hamishcoleman/thinkpad-usbkb/parts-required.ods

Sheet: Sheet1
Attempt to document required parts for a thinkpad keyboard adaptor
Keyboard Pinout:
pin 1 indicated with a silk-screen arrow on motherboard
pin 40 indicated with a circuit inscription on the keyboard
 | x230 signal | x220 signal | Pin | Pin | x220 signal | x230 signal
 | -HOTKEY | -HOTKEY | 1 | 2 | DRV4 | DRV4 | multimeter tests
 | SENSE5 | SENSE5 | 3 | 4 | DRV5 | DRV5 | red to gnd or 1
 | SENSE0 | SENSE0 | 5 | 6 | DRV8 | DRV8 | black to ledmicmute_r
 | SENSE3 | SENSE3 | 7 | 8 | DRV6 | DRV6 | led lights
 | SENSE2 | SENSE2 | 9 | 10 | DRV3 | DRV3
 | SENSE4 | SENSE4 | 11 | 12 | DRV7 | DRV7 | red to 1, black to 36, light
 | SENSE1 | SENSE1 | 13 | 14 | DRV2 | DRV2
 | SENSE6 | SENSE6 | 15 | 16 | DRV10 | DRV10 | red to 34, black to 1, continuity when Fn key pressed
 | SENSE7 | SENSE7 | 17 | 18 | DRV1 | DRV1
 | -PWRSWITCH | -PWRSWITCH | 19 | 20 | DRV9 | DRV9 | red to 34, black to 19, continuty – dropping off – when power key presses
 | ?? KBD_CN#21 | LEDCPSLOCK_CONN | 21 | 22 | DRV0 | DRV0
 | -LEDPWR | LEDPWR_CONN | 23 | 24 | DRV11 | DRV11 | red to 31ish, black to some two things in 19-25, caps lights
 | ?? KBD_CN#25 | KBDID0_CONN | 25 | 26 | DRV14 | DRV14 | red to 31ish, black to 36ish, mic lights
 | GND | KBDID1_CONN | 27 | 28 | DRV12 | DRV12
 | ?? KBD_CN#29 | KBDID2_CONN | 29 | 30 | DRV15 | DRV15
 | gnd | gnd | 31 | 32 | DRV13 | DRV13
 | -LED_MUTE | -LED_MUTE | 33 | 34 | gnd | gnd
 | VCC3M | VCC3M | 35 | 36 | -LEDMICMUTE_R | -LEDMICMUTE_R
 | TP4DATA | TP4DATA | 37 | 38 | VCC5B | VCC5
 | TP4CLK | TP4CLK | 39 | 40 | TP4_RESET | TP4_RESET
Pins needed – total
8 | Matrix rows
16 | Matrix columns
2 | misc switches (Fn and Pwr)
4 | misc LED (Pwr, Mute, Mic, Caps)
3 | Trackpoint (Reset, Clock, Data)
2 | USB
35 | total
Pins needed – with scan chip
2 | USB
2 | I2C
3 | Trackpoint (Reset, Clock, Data)
2 | misc switches (Fn and Pwr)
9 | total

Sheet: Sheet2
Mfr | Name | Est cost | CPU | $mouser | Core | Package | GPIO | USB | Flash | MHz | IC2 | $mouser | difficulty | notes
Atmel | atmega168+I2C |  | Atmega168 | 1.87 | AVR | qfp32 | 23 | vusb | 16 | 20 | TCA8424RHAR | 1.58 | 2
Atmel | atmega328+I2C |  | Atmega328 | 2.14 | AVR | qfp32 | 23 | vusb | 32 | 20 | TCA8424RHAR | 1.58 | 2
Atmel | atmega32u4 |  | Atmega32u4 | 4.37 | AVR | qfp | 26 | Hardware | 32 | 16 |  |  | 3
Atmel | atmega32u4+I2C |  | Atmega32u4 | 4.37 | AVR | qfp | 26 | Hardware | 32 | 16 | TCA8424RHAR | 1.58 | 1
Atmel | atmega48+I2C |  | Atmega48 | 1.5 | AVR | qfp32 | 23 | vusb | 4 | 20 | TCA8424RHAR | 1.58 | 2
Atmel | atsam4l |  | ATSAM4LS2AA-AU | 4.06 | Cortex M4 | tqfp48 | 32 | Hardware | 128 | 48
Atmel | attiny+I2C |  | Attiny88 | 0.679 |  |  | 28 | vusb | 8 | 12 | TCA8424RHAR | 1.58 | 3
Freescale | MKL25 |  | MKL25Z32VFT4 | 2.2 | Cortex M0+ | qfn48 |  | Hardware | 32 | 48
NXP | lpc11u12 |  | LPC11U12FBD48/201 | 2.03 | Cortex M0 | lqfp48 | 40 | Hardware | 16 | 50
NXP | lpc11u13 |  | LPC11U13FBD48/201 | 2.13 | Cortex M0 | lqfp48 | 40 | Hardware | 24 | 50
NXP | lpc11u14 |  | LPC11U14FBD48/201 | 2.22 | Cortex M0 | lqfp48 | 40 | Hardware | 32 | 50 |  |  |  | Olimex 8.95
NXP | lpc11u24,301 |  | LPC11U24FBD48/301 | 2.51 | Cortex M0 | lqfp48 | 40 | Hardware | 32 | 50 |  |  |  | microbuilder code base
NXP | lpc11u24,401 |  | LPC11U24FBD48/401 | 2.68 | Cortex M0 | lqfp48 | 40 | Hardware | 32 | 50 |  |  |  | microbuilder code base (more sram, more eeprom)
NXP | lpc11u34 |  | LPC11U34FBD48/311 | 2.68 | Cortex M0 | lqfp48 | 40 | Hardware | 32 | 50
NXP | lpc11u37 |  | LPC11U37FBD48/401 | 3.54 | Cortex M0 | lqfp48 | 40 | Hardware | 128 | 50 |  |  |  | microbuilder code base
NXP | lpc11u66 |  | LPC11U66JBD48E | 2.32 | Cortex M0+ | lqfp48 | 34 | Hardware | 64 | 50 |  |  | 3
NXP | lpc1343 |  | LPC1343FBD48 | 3.08 | Cortex M3 | lqfp48 | 42 | Hardware | 32 | 72 |  |  |  | Olimex 8.95
NXP | lpc1347 |  | LPC1347FBD48,151 | 4.04 | Cortex M3 | lqfp48 | 40 | Hardware | 64 | 72 |  |  |  | microbuilder code base
NXP | lpc1768 (arch pro mbed) |  | LPC1768FBD100,551 | 7.71 | Cortex M3 | lqfp100 | 70 | Hardware | 512 | 100 |  |  | 3
Si | efm32lg |  | EFM32LG332F256-QFP64 | 2.77 | Cortex M3 |  | 50 | Hardware | 128 | 48 |  |  | 3
Si | efm32zg110+I2C+soft |  | EFM32ZG110F32-QFN24 | 0.727 | Cortex M0 | qfn24 | 17 | LemcUSB | 32 | 24 | TCA8424RHAR | 1.58 | 4
Si | efm32zg222+I2C+soft |  | EFM32ZG222F32-QFP48T | 0.999 | Cortex M0+ | tqfp48 | 37 | LemcUSB | 32 | 24 | TCA8424RHAR | 1.58 | 4
Si | efm32zg222+soft |  | EFM32ZG222F32-QFP48T | 0.999 | Cortex M0 | tqfp48 | 37 | LemcUSB | 32 | 24 |  |  | 4
STM | stm32f042 (unstocked) |  | STM32F042C6T6 | 2.16 | Cortex M0 | lqfp48 | 38 | Hardware | 32 | 48
STM | stm32f072 (unstocked) |  | STM32F072C8U6 | 2.47 | Cortex M0 | lqfp48 | 37 | Hardware | 64 | 48 |  |  |  | Crystal-less
STM | stm32f102 |  | STM32F102C4T6A | 2.57 | Cortex M3 | lqfp48 | 37 | Hardware | 16 | 48
STM | stm32f103 |  | STM32F103R4T6A | 3.28 | Cortex M3 | lqfp64 | 51 | Hardware | 64 | 72 |  |  |  | Olimex 12.95
STM | stm32f103c8 |  | STM32F103C8T6 | 4.39 | Cortex M3 | lqfp48 | 37 | Hardware | 64 | 72 |  |  |  | 4.48 http://www.dx.com/p/337043
STM | stm32f302 |  | STM32F302C8T6 | 3.32 | Cortex M4 | lqfp48 | 51 | Hardware | 32 | 72 |  |  |  | needs power up sequencing...
STM | stm32l053 |  | STM32L053C8T6 | 3.24 | Cortex M0+ | lqfp48 | 37 | Hardware | 32 | 32
STM | stm32l152 |  | STM32L152R8T6 | 3.92 | Cortex M3 | lqfp64 | 51 | Hardware | 64 | 32 |  |  |  | Olimex 14.95
TI | lm4f120 |  |  |  |  |  |  | Hardware
Si | efm32tg222 |  | EFM32TG222F32-QFP48 | 1.27 | Cortex M3 | qfp48 | 37 | LemcUSB? | 32 | 32
Si | efm32g222 |  |  | ? | Cortex M3 | qfp48 | 37 | LemcUSB? | 128 | 32
Si | efm32lg232 |  | EFM32LG232F256G-E-QFP64 | ? | Cortex M3 | qfp64 | 53 | LemcUSB? | 256 | 48
Si | efm32gg232 |  | EFM32GG232F1024-QFP64 | ? | Cortex M3 | qfp64 | 53 | LemcUSB? | 1024 | 48
Si | efm32wg232f256 |  | EFM32WG232F256-QFP64 | 3 | Cortex M4F | qfp64 | 53 | LemcUSB? | 256 | 48 |  |  |  | Has different pinout with hardware USB
Si | efm32wg232f128 |  | EFM32WG232F128-QFP64 | 2.57 | Cortex M4F | qfp64 | 53 | LemcUSB? | 128 | 48 |  |  |  | Has different pinout with hardware USB
Si | efm32lg232 |  | EFM32LG232F256G-E-QFP64 | ? | Cortex M3 | qfp64 | 53 | LemcUSB? | 256 | 48 |  |  |  | Has different pinout with hardware USB
Si | efm32lg332 |  | EFM32LG332F256G-E-QFP64 | ? | Cortex M3 | qfp64 | 50 | Hardware | 256 | 48
Si | efm32gg232 |  | EFM32GG332F1024-QFP64 | ? | Cortex M3 | qfp64 | 50 | LemcUSB? | 1024 | 48
Freescale |  |  | MKL26Z64VFT4 | 2.07 | Cortex M0 | qfn48 |  |  | 64 | 48

Sheet: Sheet3
libraries and frameworks:
 | http://libopencm3.org/wiki/Main_Page
 | chibios
 | microbuilder
 | http://www.energymicro.com/downloads/software
stm32f102 | http://libopencm3.org/wiki/Main_Page
lpc11xx? | https://code.google.com/p/lpc1343codebase/
lpc11u24 | https://github.com/microbuilder/LPC11U_LPC13U_CodeBase
lpc11u24 | mbed
lpc11u24 | http://www.embeddedartists.com/products/lpcxpresso/lpc11U24_xpr.php | 20€
lpc1343 dev env | http://vn1k.blogspot.co.uk/2010/11/lpc1343-setting-up-development.html
stm32f102 basic board | http://kevinjoly25.wordpress.com/2013/12/27/usb-hid-device/
stm32f103 | https://gitorious.org/gnuk
? | freeRTOS
? | lwip
? | nxpUSBlib
efm32 emlib | https://github.com/viswesr/EnergyMicro-Peripheral-Library

Sheet: Sheet4
Date | Vendor | Manuf | Part | 1 | 10 | 25 | 50 | 100 | 250 | 500 | 1000
42135 | uk.Mouser.com | Si | EFM32ZG222F32-QFP48T | 1.25 | 1.18 | 1.14 | 1.11 | 1.04 | 1.01 | 0.95 | 0.936
42135 | uk.farnell.com | Si | EFM32ZG222F32-QFP48T | 1.05 |  | 0.972 |  | 0.936 |  |  | 0.912
42135 | uk.rs-online.com | Si | EFM32ZG222F32-QFP48T | 1.04 |  | 1.03
