hamishcoleman/thinkpad-usbkb/palm/Anschluss_Tastenmatrix_en-us_jumper.ods

EN-US | J2-1 J3-1 | J2-4 | J4-7 | J3-2 | J2-2 J3-8 | J2-3 J3-3 | J3-9 J4-10 | J3-10 J4-8 | J3-11 J4-6 | J3-12 J4-9 | J2-5 | J2-7 J4-4
J3-4 | 4 |  |  | c | r | f | 8 | u | j | m
J3-5 | 5 |  |  | v | t | g | 9 | i | k | ,
J3-6 | 6 |  |  | b | y | h | 0 | o | l | .
J3-7 | 7 |  |  | n | ` ~ | space | space2 | p | ; | done
J2-10; J4-1 | 1 | Caps | Del |  | cmd | x | - | [ | „“ | / |  | Shft L
J2-9; J4-2 | 2 | tab | left |  | q | a | + | ] | enter | up |  | shf R
J2-8; J4-3 | 3 | ctrl | down |  | w | s | BckSpce | \ | ToDo | Memo | Fn
J2-6; J4-5 | z |  | right |  | e | d | Date | Phone |  |  | alt
