hamishcoleman/thinkpad-usbkb/palm/board_redraw.dxf

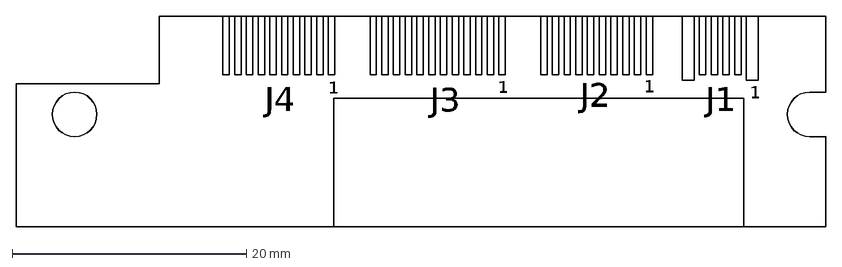
[picture p1: CAD file, 2015-03-04]
palm/board_redraw.dxf
1
J1
J2
J3
J4
