hamishcoleman/thinkpad-usbkb/keyboard.kicad_pcb

## KiCad design keyboard.kicad_pcb (2015-05-12)

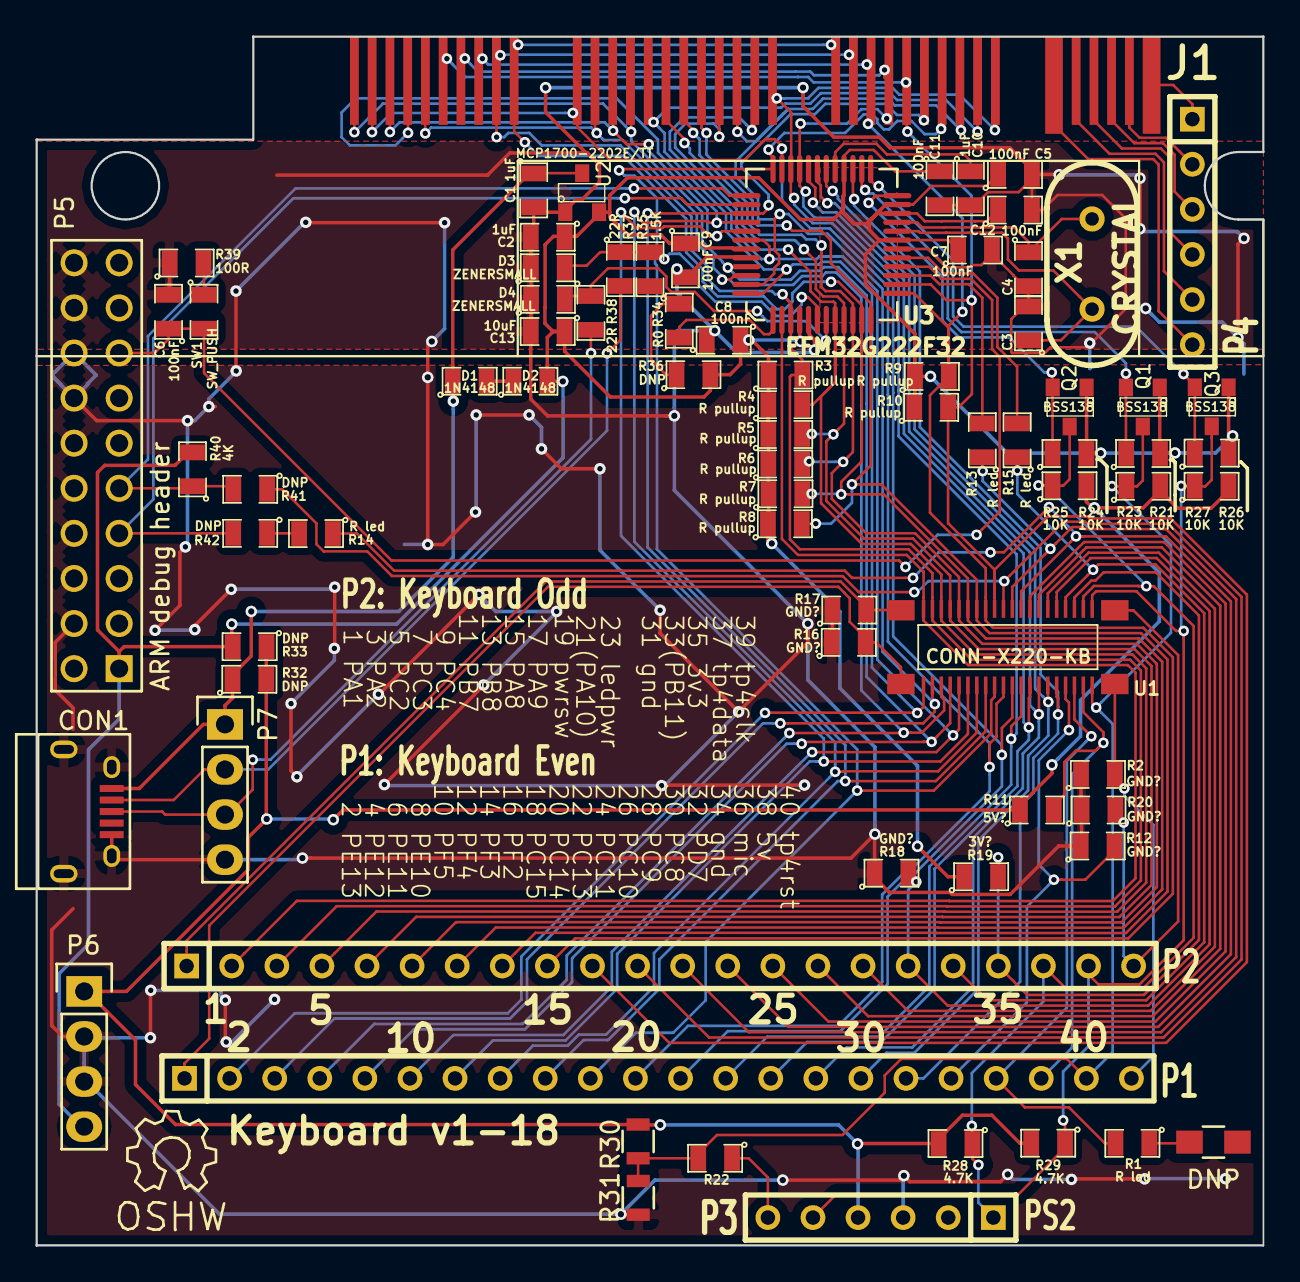
[picture p2: board keyboard.kicad_pcb from above]

Board: 2 copper layers, 69.1 x 68.1 mm, 76 parts (0 on the bottom side), 75 nets.

Parts:
C1, C2, C10: 1uF; SM0805
C3, C4: C; SM0805
C5, C6, C7, C8, C9, C11, C12: 100nF; SM0805
C13: 10uF; SM0805
CON1: USB-MICRO-B; USB_Micro-B
D1, D2: 1N4148; SM0805
D3, D4: ZENERSMALL; SM0805
J1: CONN-PALM-FOLD-KB; conn-palm-fold-kb
P1: P1: Keyboard Even; SIL-26
P2: P2: Keyboard Odd; SIL-26
P3: PS2; SIL-6
P4: Palm Serial; SIL-6
P5: ARM debug header; pin_array_10x2
P6: Power; Pin_Header_Straight_1x04
P7: USB_H; Pin_Header_Straight_1x04
Q1, Q2, Q3: BSS138; SOT23
R1, R13, R14, R15: R led; SM0805
R2, R12, R16, R17, R18, R20: GND?; SM0805
R3, R4, R5, R6, R7, R8, R9, R10: R pullup; SM0805
R11: 5V?; SM0805
R19: 3V?; SM0805
R21, R23, R24, R25, R26, R27: 10K; SM0805
R22, R34: R0; SM0805
R28, R29: 4.7K; SM0805
R30, R31: DNP; R_0805
R32, R33, R36, R41, R42: DNP; SM0805
R35: 1.5K; SM0805
R37, R38: 22R; SM0805
R39: 100R; SM0805
R40: 4K; SM0805
SW1: SW_PUSH; SM0805
U1: CONN-X220-KB; AA01B-S040VA1
U2: MCP1700-2202E/TT; SOT23
U3: EFM32G222F32; EFM32_TQFP48
X1: CRYSTAL; HC-49V

Connections:
+3V3: C2.1, C5.1, C7.1, C8.1, C9.1, C11.1, C12.1, C13.1, D2.2, P5.1, P6.4, Q1.1, Q2.1, Q3.1, R3.1, R4.1, R5.1, R6.1, R7.1, R8.1, R9.1, R10.1, R19.1, R21.2, R24.2, R26.2, R33.2, R36.2, R40.2, U2.2, U3.4, U3.19, U3.22, U3.23, U3.28, U3.43
+5V: P3.4, P6.1, R11.1, R23.2, R25.2, R27.2, R28.2, R29.2, R30.2, R32.2, R33.1
/keyboard-efm32/#RESET: C6.1, P5.15, SW1.2, U3.16
/keyboard-efm32/SWCLK: P5.9, R40.1, R41.2, U3.37
/keyboard-efm32/SWDIO: P5.7, R42.2, U3.38
/keyboard-efm32/USB_DM: D3.2, R35.2, R37.1, U3.6
/keyboard-efm32/USB_DP: D4.2, R38.1, U3.7
/keyboard-efm32/USB_SENSE: R34.1, U3.1
/keyboard-efm32/ps2_clk: Q3.2, R26.1, U3.25
/keyboard-efm32/ps2_data: Q2.2, R24.1, U3.24
/keyboard-efm32/ps2_reset: Q1.2, R21.1, U3.26
/keyboard-power/VBUS: C1.1, CON1.1, D1.1, P7.1, R32.1, U2.3
GND: C1.2, C2.2, C3.2, C4.2, C5.2, C6.2, C7.2, C8.2, C9.2, C10.2, C11.2, C12.2, C13.2, CON1.5, CON1.6, CON1.7, CON1.8, CON1.9, D3.1, D4.1, P3.3, P5.4, P5.6, P5.8, P5.10, P5.12, P5.14, P5.16, P5.18, P5.20, P6.2, P6.3, P7.4, R2.1, R12.1, R16.1, R17.1, R18.1, R20.1, R31.1, R39.1, U2.1, U3.5, U3.18, U3.44
unnamed: C3.1, U3.20, X1.1
unnamed: C4.1, U3.21, X1.2
unnamed: C10.1, U3.29
unnamed: CON1.2, P7.2, R37.2
unnamed: CON1.3, P7.3, R38.2
unnamed: D1.2, D2.1
unnamed: J1.1, P4.1
unnamed: J1.2, P4.2
unnamed: J1.3, P4.3
unnamed: J1.4, P4.4
unnamed: J1.5, P4.5
unnamed: J1.6, P4.6
unnamed: P1.1, R16.2, U1.42
unnamed: P1.18, R12.2, U1.34
unnamed: P1.19, R1.2, U1.36
unnamed: P1.20, R11.2, U1.38
unnamed: P1.22, R2.2, U1.44
unnamed: P2.1, R17.2, U1.41
unnamed: P2.12, R13.1, U1.21
unnamed: P2.13, R14.1, U1.23
unnamed: P2.17, R18.2, U1.31
unnamed: P2.18, R15.1, U1.33
unnamed: P2.19, R19.2, U1.35
unnamed: P2.22, R20.2, U1.43
unnamed: P3.6, R22.1
unnamed: R34.2, R35.1, R36.1
unnamed: R39.2, SW1.1
col1: J1.7, J1.17, P1.12, U1.22, U3.34
col2: J1.10, P1.10, U1.18, U3.36
col3: J1.35, P1.8, U1.14, U3.40
col4: J1.18, P1.6, U1.10, U3.42
col5: J1.8, J1.24, P1.2, U1.2, U3.48
col6: J1.9, J1.19, P1.3, U1.4, U3.47
col7: J1.25, J1.38, P1.5, U1.8, U3.45
col8: J1.26, J1.36, P1.7, U1.12, U3.41
col9: J1.27, J1.34, P1.4, U1.6, U3.46
col10: J1.28, J1.37, P1.11, U1.20, U3.35
col11: J1.11, P1.9, U1.16, U3.39
col12: J1.13, J1.32, P1.13, U1.24, U3.33
col13: P1.15, U1.28, U3.31
col14: P1.17, U1.32, U3.27
col15: P1.14, U1.26, U3.32
col16: P1.16, U1.30, U3.30
hotkey: P2.2, U1.1, U3.2
kbdid0: P2.14, U1.25
kbdid1: P2.15, U1.27
kbdid2: P2.16, U1.29
led_mute: R15.2, U3.17
ledcpslock: R13.2, U3.15
ledpwr: R14.2, R42.1
pwrswitch: P2.11, R41.1, U1.19
row1: J1.20, P2.4, R4.2, U1.5, U3.8
row2: J1.21, P2.8, R8.2, U1.13, U3.12
row3: J1.22, P2.6, R6.2, U1.9, U3.10
row4: J1.23, P2.5, R5.2, U1.7, U3.9
row5: J1.16, J1.29, P2.7, R7.2, U1.11, U3.11
row6: J1.15, J1.30, P2.3, R3.2, U1.3, U3.3
row7: J1.14, J1.31, P2.9, R9.2, U1.15, U3.13
row8: J1.12, J1.33, P2.10, R10.2, U1.17, U3.14
tp4_clk: P2.21, P3.5, Q3.3, R27.1, R29.1, U1.39
tp4_reset: P1.21, Q1.3, R22.2, R23.1, R30.1, R31.2, U1.40
tp4data: P2.20, P3.1, Q2.3, R25.1, R28.1, U1.37
