hamishcoleman/thinkpad-usbkb/keyboard-conn-palm.sch

## KiCad design keyboard-conn-palm.sch (2015-03-27, an earlier design)

Schematic: keyboard-conn-palm.sch

Parts:
J1: CONN-PALM-FOLD-KB; MODULE
P4: CONN_6
