hamishcoleman/thinkpad-usbkb/keyboard-conn-x220.sch

## KiCad design keyboard-conn-x220.sch (2015-03-27, an earlier design)

Schematic: keyboard-conn-x220.sch

Parts:
GS1, GS2, GS3, GS4, GS5, GS6, GS7, GS8: GS2
P1, P2: CONN_25
R1, R2, R3, R4, R5, R6, R7, R8, R9, R10, R11, R12, R13, R14, R15: R
U1: CONN-X220-KB; MODULE
