hamishcoleman/thinkpad-usbkb/keyboard.sch

## KiCad design keyboard.sch (2015-03-27, an earlier design)

Schematic: keyboard.sch

Parts:
P1, P2: CONN_25
U1: CONN-X220-KB; MODULE
