hamishcoleman/thinkpad-usbkb/(commit log)

2015-03-03 Add pre-git notes to project
    [parts-required.ods]
2015-03-04 Add some details for an old palm foldable keyboard
    [Anschluss_Tastenmatrix_en-us_jumper.ods, board_redraw.dxf]
2015-03-19 Add a footprint for the keyboard connector
2015-03-20 Add schematic component for keyboard
2015-03-20 Update connector to use correct footprint
2015-03-20 Add a connector for the palm keyboard
2015-03-20 Add keyboard project, with initial schematic and pcb layout
    [keyboard.brd, keyboard.sch]
2015-03-20 Add the start of a footprint for the palm folding keyboard
2015-03-20 Update keyboard
    [keyboard.sch]
2015-03-20 Start work on PCB - note, using newer kicad
    [keyboard.kicad_pcb]
2015-03-20 Slight correction of the palm footprint
    [keyboard.kicad_pcb]
2015-03-20 Add two dimension squares to the PCB
    [keyboard.kicad_pcb]
2015-03-20 Add an option jumper for the reset line going to the PS2 connector
    [keyboard.sch]
2015-03-20 Add another jumper option and update pcb
    [keyboard-conn-palm.sch, keyboard.kicad_pcb, keyboard.sch]
2015-03-20 Move thinkpad keyboard connector to a sub sheet
    [keyboard-conn-palm.sch, keyboard-conn-x220.sch, keyboard.sch]
2015-03-21 Split into more sheets, adding ps2mouse and power
    [keyboard-conn-palm.sch, keyboard-conn-x220.sch, keyboard-power.sch, keyboard-ps2mouse.sch, keyboard.sch]
2015-03-21 Add USB port
    [keyboard-conn-palm.sch, keyboard-conn-x220.sch, keyboard-power.sch, keyboard-ps2mouse.sch, keyboard-usb.sch, keyboard.sch]
2015-03-21 Add footprints from https://github.com/EnergyMicro/HackaGecko/blob/master/Kicad_3D/Footprints/EnergyMicro.mod
2015-03-21 Add new sheet for microcontroller
    [keyboard-conn-palm.sch, keyboard-conn-x220.sch, keyboard-efm32.sch, keyboard-power.sch, keyboard-ps2mouse.sch, keyboard-usb.sch, keyboard.kicad_pcb, keyboard.sch]
2015-03-22 Join microcontroller to all the peripherals
    [keyboard-conn-palm.sch, keyboard-conn-x220.sch, keyboard-efm32.sch, keyboard-power.sch, keyboard-ps2mouse.sch, keyboard-usb.sch, keyboard.sch]
2015-03-22 Correct pin directions for ldo
2015-03-22 assign part numbers, also document two keyboard connections that we had no gpio for
    [keyboard-conn-x220.sch, keyboard-efm32.sch, keyboard-power.sch, keyboard-ps2mouse.sch, keyboard-usb.sch]
2015-03-22 Assign footprints
    [keyboard-conn-x220.sch, keyboard.sch]
2015-03-22 When we no longer need SWD, we can use two more keyboard io lines
    [keyboard-efm32.sch, keyboard.sch]
2015-03-22 Import all components into PCB
    [keyboard.kicad_pcb]
2015-03-22 Give some components better labels, start playing around with initial part placement
    [keyboard-conn-palm.sch, keyboard-conn-x220.sch, keyboard.kicad_pcb]
2015-03-22 Overlay the palm pcb footprint and start jamming parts into that shape
    [keyboard.kicad_pcb]
2015-03-22 Attempt to interpret http://tinyurl.com/hvpcbfaq as kicad config
    [keyboard.kicad_pcb]
2015-03-22 First pass at joining up the duplicated palm connections
    [keyboard.kicad_pcb]
2015-03-23 Route most of the palm board, ensuring that there was also enough escape for the rest of the board
    [keyboard.kicad_pcb]
2015-03-25 BUG: diode droppers end up at 3.3v, not 5v
    [keyboard-power.sch]
2015-03-27 Fully routed board, done with new kicad 5533
    [keyboard-conn-palm.sch, keyboard-conn-x220.sch, keyboard-efm32.sch, keyboard-power.sch, keyboard-ps2mouse.sch, keyboard-usb.sch, keyboard.kicad_pcb, keyboard.sch]
2015-03-27 Tidy up silkscreen and one gnd plane misplaced via
    [keyboard.kicad_pcb]
2015-03-27 Adjust palm connector silkscreen to really not show up
    [keyboard.kicad_pcb]
2015-03-27 Add open source logo
    [keyboard.kicad_pcb]
2015-03-27 Fix nets crossing - GND with reset
    [keyboard.kicad_pcb]
2015-03-27 Ran DRC and it wanted to save the change - cannot see any change
    [keyboard.kicad_pcb]
2015-03-29 Add micro usb footprint from dangerous prototypes - https://dangerous-prototypes-open-hardware.googlecode.com/svn/trunk/Kicad_Part_Library
2015-03-30 Update USB footprint, clean up more minor PCB warts
    [keyboard.kicad_pcb, parts-required.ods]
2015-03-31 Add pin some labels to silkscreen
    [keyboard.kicad_pcb]
2015-03-31 Bump version number on board
    [keyboard.kicad_pcb]
2015-03-31 Fix extra traces under microsd
    [keyboard.kicad_pcb]
2015-03-31 Imported board_redraw_dimensions.dxf and adjusted the Palm footprint to match. Note: it still needs fixing in module
    [keyboard.kicad_pcb]
2015-03-31 Bump version number on silkscreen
    [keyboard.kicad_pcb]
2015-03-31 Do DRC and reflow fill
    [keyboard.kicad_pcb]
2015-03-31 Clean up silkscreen cheat sheet, mostly moving breakout description
    [keyboard.kicad_pcb]
2015-04-01 Increase size of x220 pad sizes
    [keyboard.kicad_pcb]
2015-04-01 Add gerber outputs into ignored list
2015-04-01 Add a project URL
    [keyboard.kicad_pcb]
2015-05-12 Start generating a solder stencil output, and update the edge connector to not need paste
    [keyboard.kicad_pcb]
2015-06-07 Update parts spreadsheet with some quick re-quotes on the EFM32 cpu
    [parts-required.ods]
2017-01-26 Add some basic SWD programming information
    [examples.cfg]
